Martian-0007/kicad/prj/zf-filter/FILTR.pdf

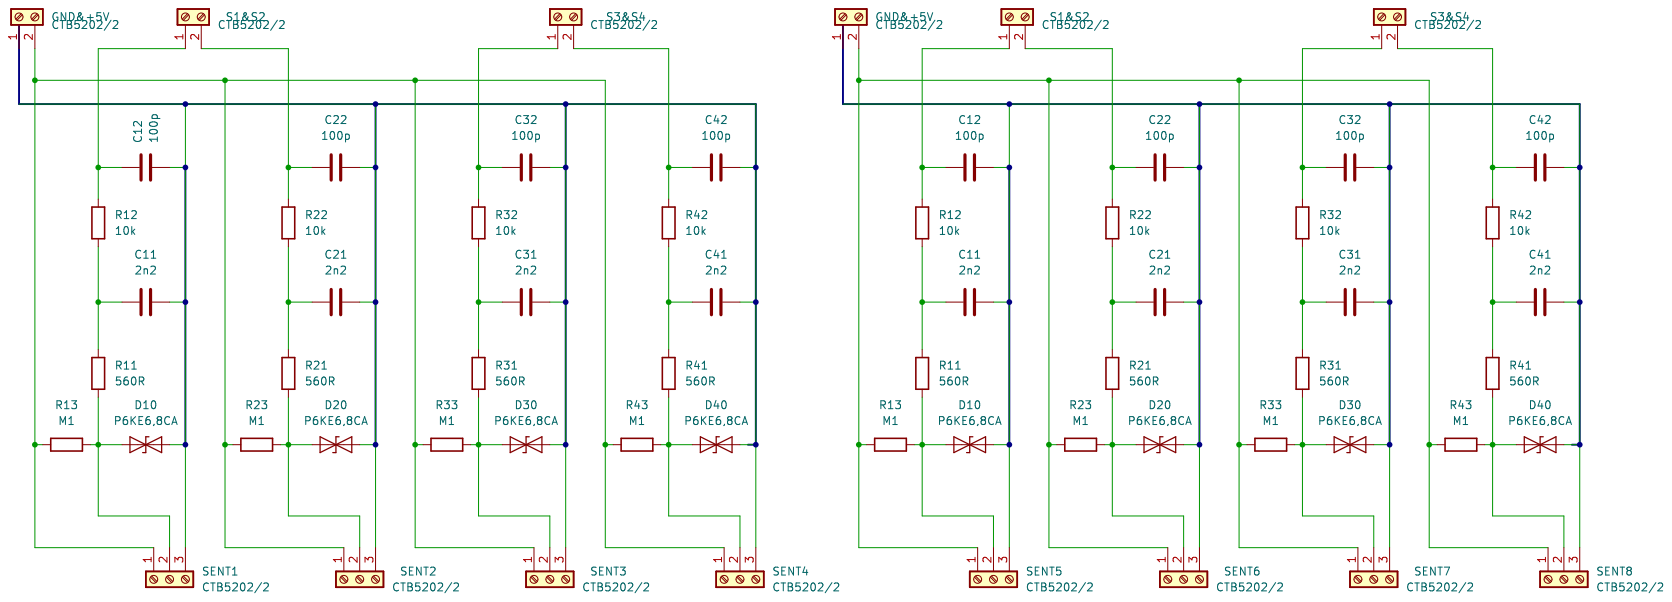
[picture p1: page 1]
