Martian-0007/kicad/prj/zf-filter/zf-filter.kicad_pcb

## KiCad design prj/zf-filter/zf-filter.kicad_pcb (2024-04-03)

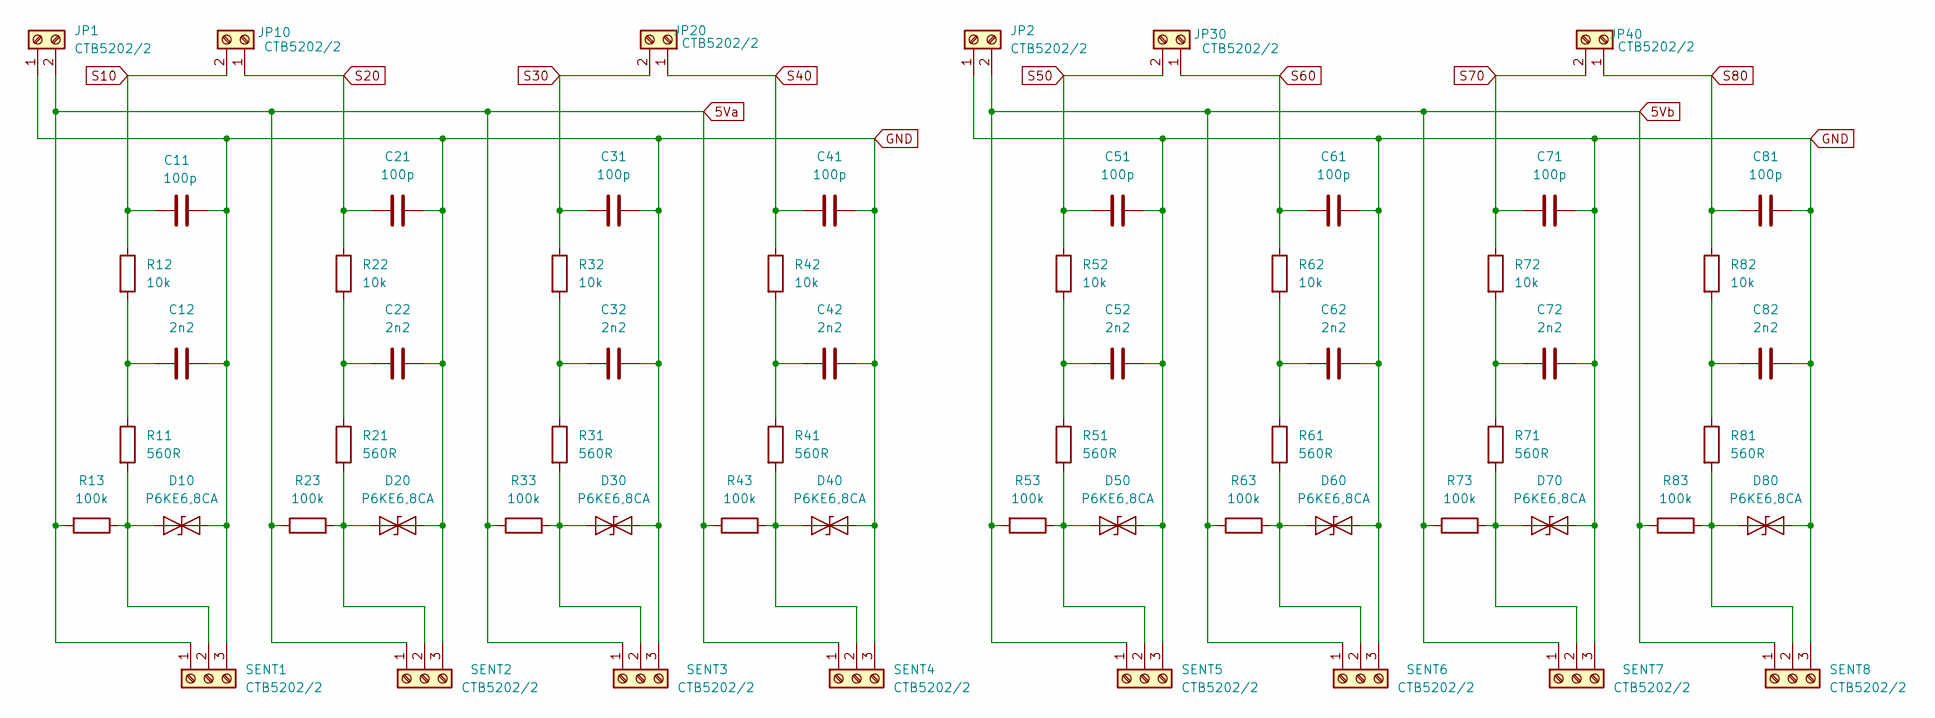
[picture p2: schematic zf-filter.kicad_sch]

Parts:
C11, C21, C31, C41, C51, C61, C71, C81: 100p; C_Disc_D6.0mm_W2.5mm_P5.00mm
C12, C22, C32, C42, C52, C62, C72, C82: 2n2; C_Rect_L7.2mm_W3.0mm_P5.00mm_FKS2_FKP2_MKS2_MKP2
D10, D20, D30, D40, D50, D60, D70, D80: P6KE6,8CA; D-THT-P6KE
JP1, JP2, JP10, JP20, JP30, JP40: CTB5202/2; TerminalBlock_RND_205-00001_1x02_P5.00mm_Horizontal
R11, R21, R31, R41, R51, R61, R71, R81: 560R; R_Axial_DIN0207_L6.3mm_D2.5mm_P10.16mm_Horizontal
R12, R22, R32, R42, R52, R62, R72, R82: 10k; R_Axial_DIN0207_L6.3mm_D2.5mm_P10.16mm_Horizontal
R13, R23, R33, R43, R53, R63, R73, R83: 100k; R_Axial_DIN0207_L6.3mm_D2.5mm_P10.16mm_Horizontal
SENT1, SENT2, SENT3, SENT4, SENT5, SENT6, SENT7, SENT8: CTB5202/2; TerminalBlock_RND_205-00002_1x03_P5.00mm_Horizontal

Connections:
5Va: JP1.2, R13.2, R23.1, R33.1, R43.1, SENT1.1, SENT2.1, SENT3.1, SENT4.1
5Vb: JP2.2, R53.2, R63.1, R73.1, R83.1, SENT5.1, SENT6.1, SENT7.1, SENT8.1
GND: C11.2, C12.2, C21.2, C22.2, C31.2, C32.2, C41.2, C42.2, C51.2, C52.2, C61.2, C62.2, C71.2, C72.2, C81.2, C82.2, D10.2 (A2), D20.2 (A2), D30.2 (A2), D40.2 (A2), D50.2 (A2), D60.2 (A2), D70.2 (A2), D80.2 (A2), JP1.1, JP2.1, SENT1.3, SENT2.3, SENT3.3, SENT4.3, SENT5.3, SENT6.3, SENT7.3, SENT8.3
unnamed: C12.1, R11.1, R12.2
unnamed: C22.1, R21.1, R22.2
unnamed: C32.1, R31.1, R32.2
unnamed: C42.1, R41.1, R42.2
unnamed: C52.1, R51.1, R52.2
unnamed: C62.1, R61.1, R62.2
unnamed: C72.1, R71.1, R72.2
unnamed: C82.1, R81.1, R82.2
unnamed: D10.1 (A1), R11.2, R13.1, SENT1.2
unnamed: D20.1 (A1), R21.2, R23.2, SENT2.2
unnamed: D30.1 (A1), R31.2, R33.2, SENT3.2
unnamed: D40.1 (A1), R41.2, R43.2, SENT4.2
unnamed: D50.1 (A1), R51.2, R53.1, SENT5.2
unnamed: D60.1 (A1), R61.2, R63.2, SENT6.2
unnamed: D70.1 (A1), R71.2, R73.2, SENT7.2
unnamed: D80.1 (A1), R81.2, R83.2, SENT8.2
S10: C11.1, JP10.2, R12.1
S20: C21.1, JP10.1, R22.1
S30: C31.1, JP20.2, R32.1
S40: C41.1, JP20.1, R42.1
S50: C51.1, JP30.2, R52.1
S60: C61.1, JP30.1, R62.1
S70: C71.1, JP40.2, R72.1
S80: C81.1, JP40.1, R82.1

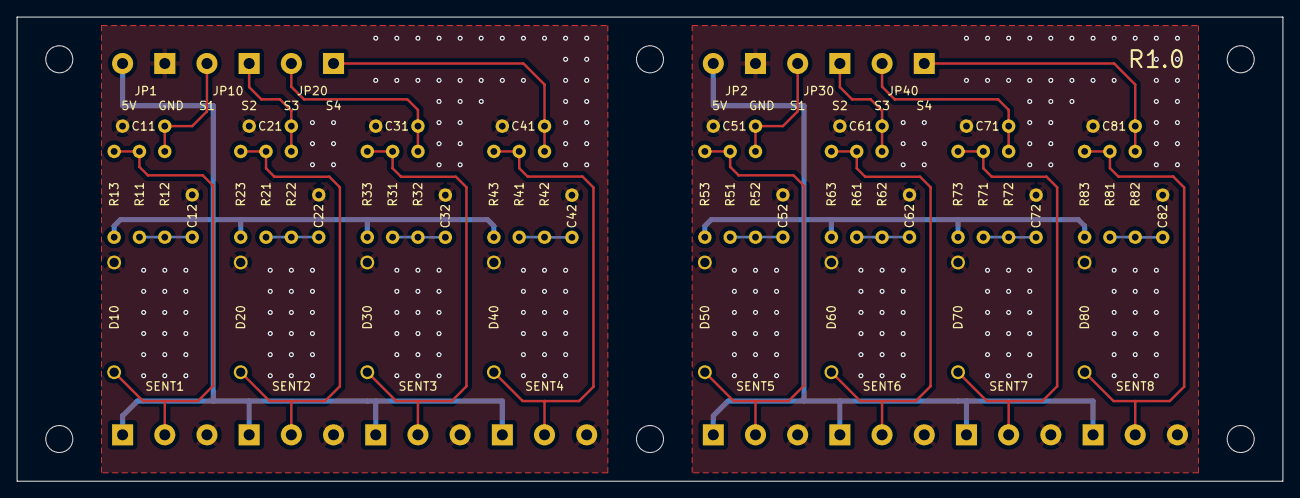
[picture p3: board zf-filter.kicad_pcb from above]

Board: 2 copper layers, 150.0 x 55.0 mm, 62 parts (0 on the bottom side), 27 nets.
