Martian-0007/kicad/(commit log)

2024-02-28 Add KARA UAS ANT24A
    [kara-uas-ant24a.kicad_pcb, kara-uas-ant24a.kicad_sch]
2024-03-06 Add converted and KiCad default libraries and reiew kara-uas-ant-24-a
    [kara-uas-ant24a.kicad_pcb, kara-uas-ant24a.kicad_sch]
2024-03-11 Corrections to kara-uas-ant-24-a
    [kara-uas-ant24a.kicad_pcb]
2024-03-12 kara-uas-ant-24-a - center silkscreen frequency numbers
    [kara-uas-ant24a.kicad_pcb]
2024-03-12 kara-uas-ant-24-a - generate gerbers
    [kara-uas-ant24a-B_Cu.gbl, kara-uas-ant24a-B_Mask.gbs, kara-uas-ant24a-B_Paste.gbp, kara-uas-ant24a-B_Silkscreen.gbo, kara-uas-ant24a-Edge_Cuts.gm1, kara-uas-ant24a-F_Cu.gtl, kara-uas-ant24a-F_Mask.gts, kara-uas-ant24a-F_Paste.gtp]
2024-03-12 kara-uas-ant-24-a - regenerate gerbers
    [bot.gbl, dim.gm1, kara-uas-ant24a-B_Cu.gbl, kara-uas-ant24a-B_Mask.gbs, kara-uas-ant24a-B_Paste.gbp, kara-uas-ant24a-B_Silkscreen.gbo, kara-uas-ant24a-NPTH-drl_map.gbr, kara-uas-ant24a-NPTH.drl]
2024-03-13 Remove silkscreen from used footprints
2024-03-13 Add ZF-Filter
    [Filtr.kicad_pcb, Filtr.kicad_sch]
2024-03-20 move libraries 2/2
    [Filtr.kicad_sch, zf-filter.kicad_pcb, zf-filter.kicad_sch]
2024-03-20 zf-filter r1.0
    [zf-filter.kicad_pcb, zf-filter.kicad_sch]
2024-03-26 zf-filter r0.1
    [zf-filter.kicad_pcb, zf-filter.kicad_sch]
2024-03-26 Add SamacSys loader libs
    [zf-filter.kicad_pcb]
2024-03-26 zf-filter r0.2
    [zf-filter.kicad_pcb]
